jepeloa/firmware.gbotv4/Schematic_gbot_v3.drawio.png

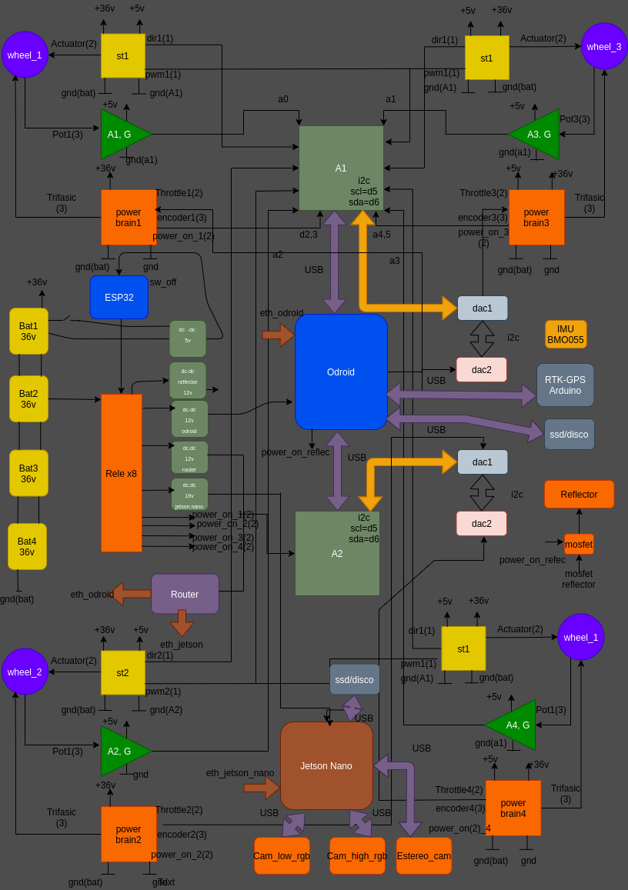
Schematic_gbot_v3.drawio.png
