jepeloa/firmware.gbotv4/wires/wires_AC1.png

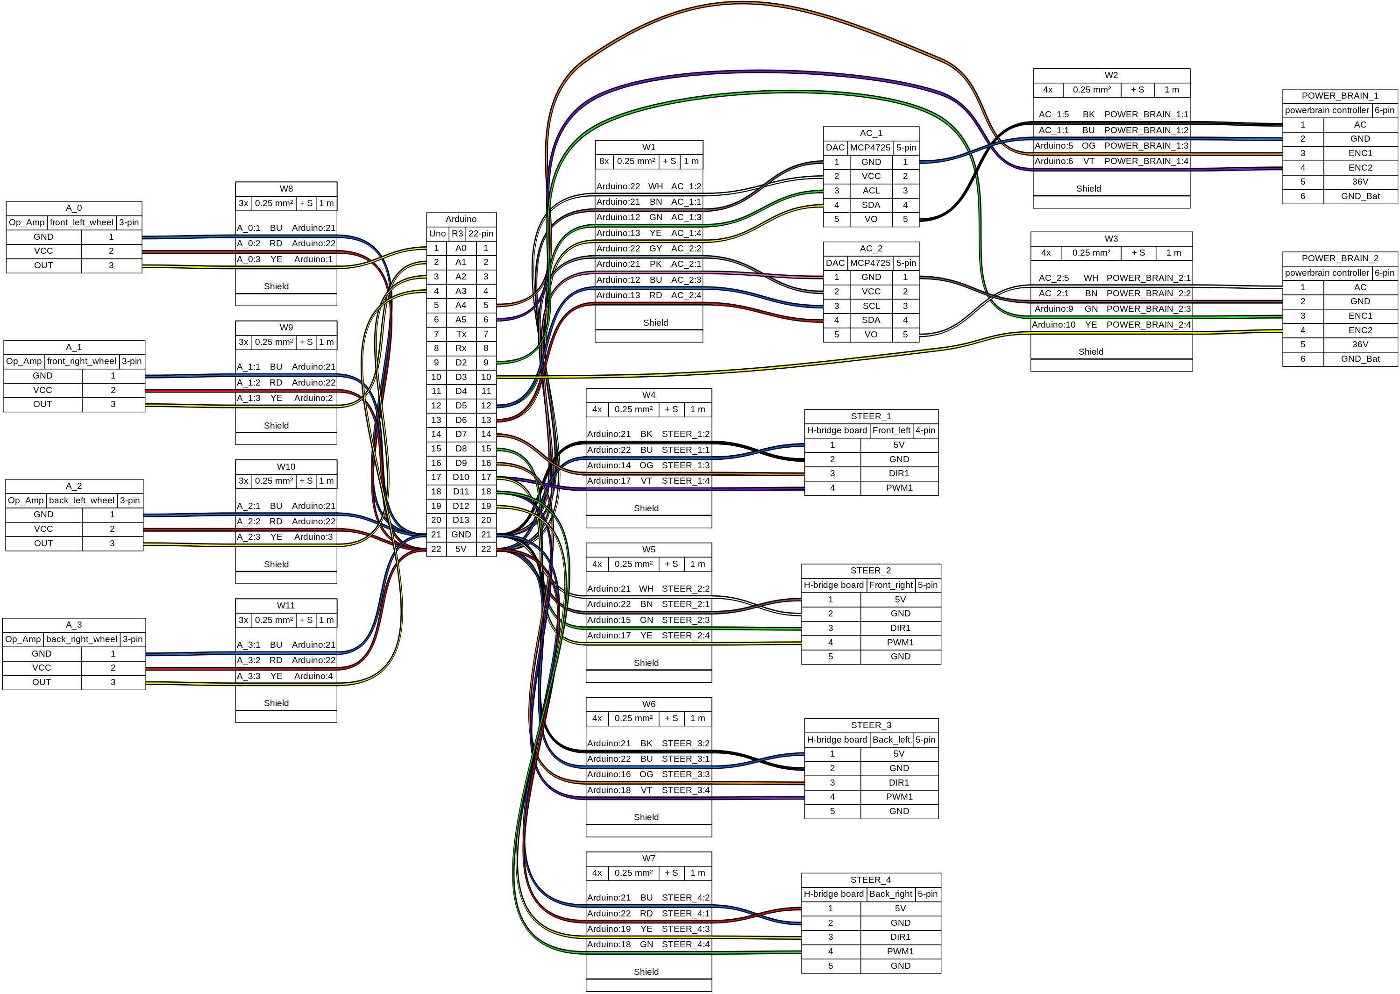
wires/wires_AC1.png
