jepeloa/firmware.gbotv4/wires/wires_AC2.png

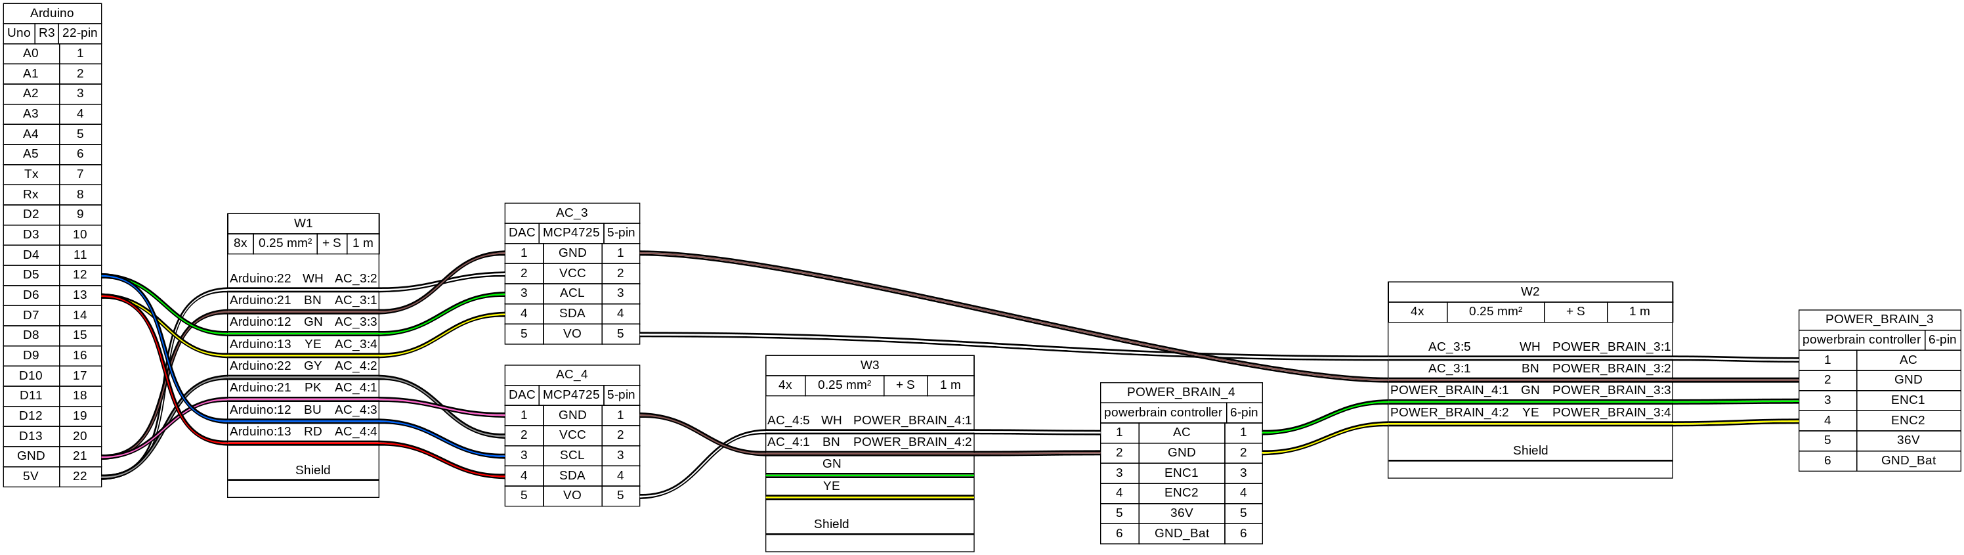
wires/wires_AC2.png
