jepeloa/firmware.gbotv4/sim_ros/ros_gbot_v6/meshes/camera_link.STL

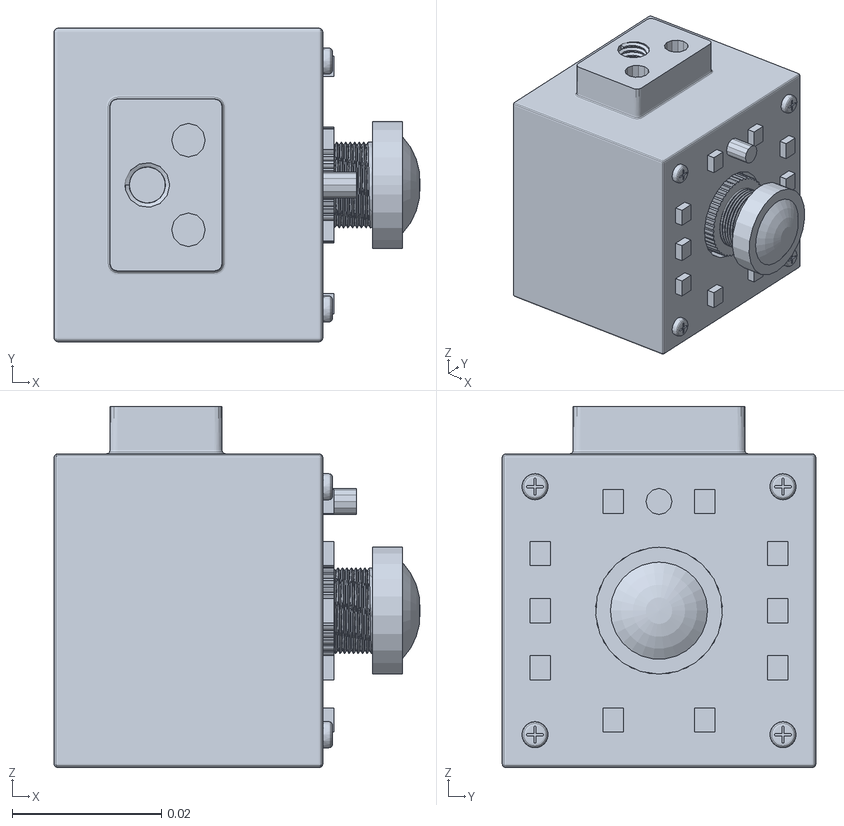
[picture p7: CAD file, 2022-08-29]
sim_ros/ros_gbot_v6/meshes/camera_link.STL
0.049 x 0.042 x 0.0483
