jepeloa/firmware.gbotv4/(commit log)

2022-08-29 Firmware robot v4 con giro en las cabeceras y marcha atras
    [camera_link.STL, ros_gbot_v6.csv, ros_gbot_v6.urdf, wires_AC1.bom.tsv, wires_AC2.bom.tsv]
2022-08-29 modificado el readme
2022-08-30 inversion de marcha agregada a traves del flag marcha pasado por la funcion digital write
